Chasebarn35/ECEN404MatrixConverter/ECEN404FSM/db/ip/InternalClock/InternalClock__report.html

InternalClock

2024.11.07.12:48:01 | Datasheet

Overview

Memory Map

## int_osc_0

altera_int_osc v23.1

Parameters

INFORMATION | The output frequency for 10M02, 10M04, 10M08, 10M16, and 10M25 devices is 55~116MHz <br>The output frequency for 10M40, and 10M50 devices is 35~77MHz <br>
DEVICE_FAMILY | MAX10FPGA
PART_NAME | 10M04SAE144C8G
DEVICE_ID | 04
CLOCK_FREQUENCY_1 | 55
CLOCK_FREQUENCY_2 | 77
CLOCK_FREQUENCY | 55
CBX_AUTO_BLACKBOX | ALL
deviceFamily | UNKNOWN
generateLegacySim | false

Software Assignments
(none)

generation took 0.00 seconds | rendering took 0.01 seconds
