Chasebarn35/ECEN404MatrixConverter/Presentations/ECEN 403 Midterm Presentation.pptx

## 3-Phase Matrix Converter Chase Barnes Daniel Loeza Shanelle Algama


## Project Description

Problem statement:
Conventional 3 Phase Motor Drivers, Variable Frequency Drives (VFDs) use AC-DC-AC Conversion
This results in decreased efficiency, along with high Harmonic Distortion that can cause problems for the connected equipment

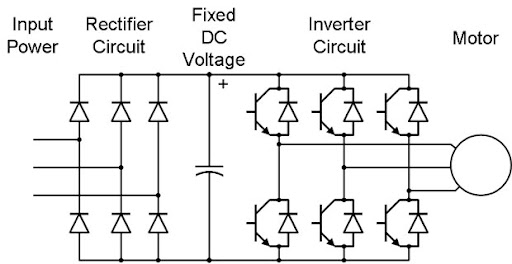
[picture p14: figure]

Notes: Chase

## Project Description

Our Matrix Converter will provide AC-AC power, and will have higher efficiency at lower frequencies than VFDs traditionally do, along with lower harmonic distortion.

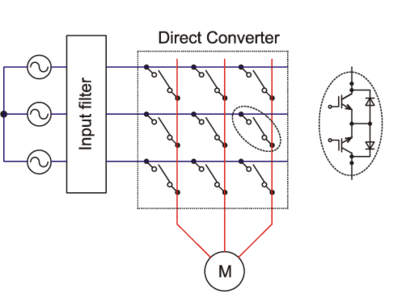
[picture p15: figure]

Notes: Chase

## Project Description

This converter will have three subsystems, which are the matrix of bidirectional switches with input filter and varistors on the input and output three-phase, the pulse generator circuit to control the switches, and the firmware, which will control the frequency of the output. The input will be 208V 60Hz three-phase power and the output will be 208V variable 0-60Hz three-phase power.

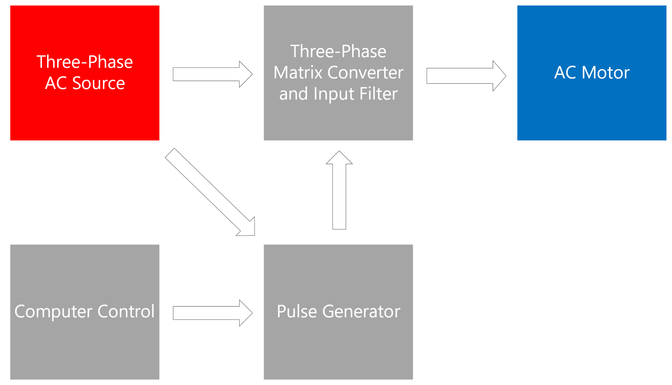
[picture p16: figure]

Notes: Shanelle

## System Overview


Notes: Shanelle

## Matrix Converter Circuit Board

This is the power electronics system designed to perform direct AC-AC conversion without an intermediate DC link.
- The source three-phase AC power will be directly connected to the input stage of the converter, which includes varistors for overvoltage protection and an input filter. (LC)
- Utilizes a 3x3 matrix of bidirectional semiconductor switches which comprises of two IGBT transistors and two gate drivers.
  - This will total to 18 IGBT transistors and 18 gate drivers
- Will include three more varistors on the output phases

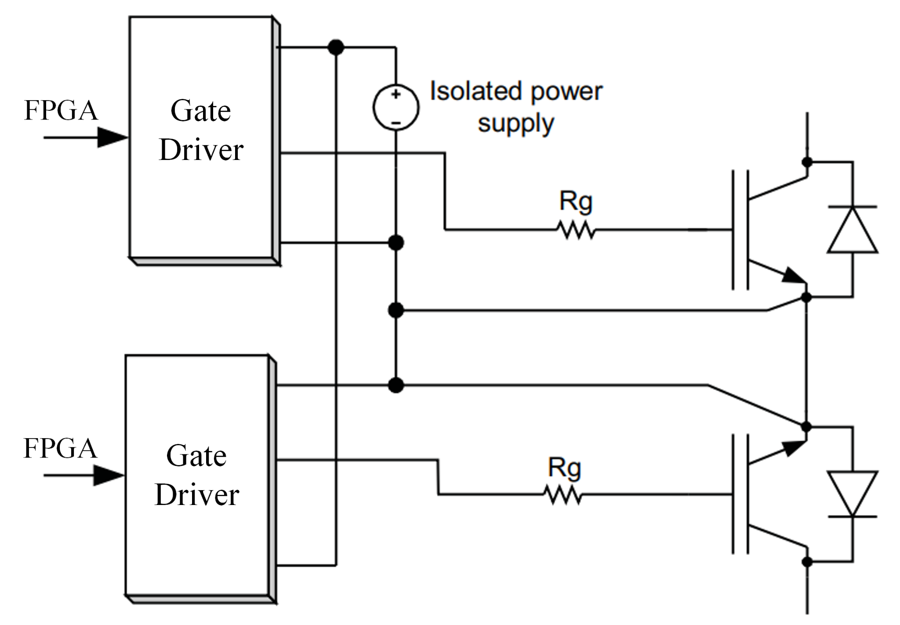
[picture p17: figure]

Bidirectional Switch with Common Emitter Configuration

Notes: Shanelle

## Pulse Generator Circuit Board

The Pulse Generator Circuit Board will house 3 sensors. These sensors will be Zero Crossing Sensors, Current Signal Detectors, and Short Circuit Detectors.
The Zero Crossing Sensor will detect when the all 3 phases change their signs.
The Current Signal Sensor will detect when either current is flowing into the load or out of the load.
The Short Circuit Sensor will detect for any short circuits within the Matrix Converter.
All outputs of these sensors will feed into the MCU/FPGA to trigger appropriate stages.

Notes: Daniel

## Microcontroller and FPGA Firmware

FPGA Firmware:
Safe Commutation System
Allows Bidirectional Switches to not short
Microcontroller Firmware:
Modeling the design virtually as a 2 stage rectifier and inverter stage allows for utilization of the Space Vector Modulation Algorithm. This is able to provide the correct load output for each phase to then be fed into the FPGA

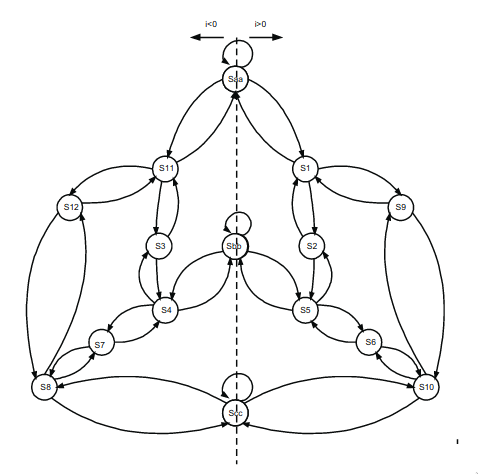
[picture p18: figure]
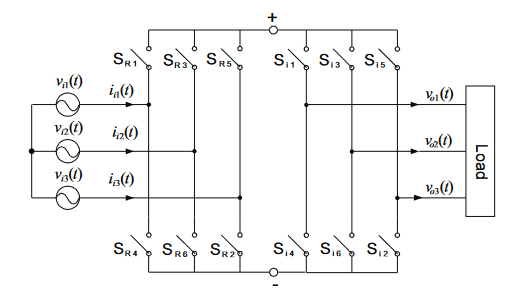
[picture p19: figure]

Notes: Chase

## Matrix Converter Circuit Board Progress

Part Type | Part Name | Info | Price | Cons
IGBT | STGW19NC60HD (https://www.digikey.com/en/products/detail/stmicroelectronics/STGW19NC60HD/2035565) | 600V 19A 97ns Td off | $3.11 Per $55.98 18x | Price
| STGP19NC60HD (https://www.digikey.com/en/products/detail/stmicroelectronics/STGP19NC60HD/2035589) | 600V 19A 97ns Td off | $2.72 Per $48.96 18x | Price
| IKP10N60TXKSA1 (https://www.digikey.com/en/products/detail/infineon-technologies/IKP10N60TXKSA1/2338008) | 600V 10A 215ns Td off 5 μs Short Protection | $1.73 Per $31.14 18x | Price Slow Td off
| STGF10M65DF2 (https://www.digikey.com/en/products/detail/stmicroelectronics/STGF10M65DF2/7313439) | 650V 10A 96ns Td off 6 μs Short Protection | $1.25 Per $22.50 18x | Plastic Packaging
Gate Drivers | HCPL-3150-000E (https://www.digikey.com/en/products/detail/broadcom-limited/HCPL-3150-000E/1236126) | 0.6 A max output 0.5 A min output | $3.26 per $58.68 18x | Price
| HCPL-315J-500E (https://www.digikey.com/en/products/detail/broadcom-limited/HCPL-315J-500E/1234709) | 0.6 A max output 0.5 A min output 2 Gate Drivers Less Components | $6.87 per $49.84 10x | Price
| HCPL-0302-000E (https://www.digikey.com/en/products/detail/broadcom-limited/HCPL-0302-000E/1236302) | 0.4 A max output 0.2 A min output | $2.24 per $26.93 18x | Lower Amperage Output
Varistor | B72220S0151K101 (https://www.digikey.com/en/products/detail/epcos-tdk-electronics/B72220S0151K101/593850) | 240V 8kA
| B72214Q0151K101 (https://www.digikey.com/en/products/detail/epcos-tdk-electronics/B72214Q0151K101/651174) | 240V 8kA

## Pulse Generator Circuit Board Process

Part Type | Part Name | Info | Price | Cons
Microcontroller | STM32G491CET6 (https://www.digikey.com/en/products/detail/stmicroelectronics/STM32G491CET6/13592600) | 512KB Flash 48-LQFP 170MHz | $8.51 per | Price
| STM32G491KEU6 (https://www.digikey.com/en/products/detail/stmicroelectronics/STM32G491KEU6/13592606) | 512KB Flash 32-UFQFPN 170MHz | $7.93 per | Smaller Package size
| STM32H733VGT6 (https://www.digikey.com/en/products/detail/stmicroelectronics/STM32H733VGT6/13171213) | 1M Flash 100-LQFP 550MHz | $12.61 per | Price
| STM32H745ZIT6 (https://www.digikey.com/en/products/detail/stmicroelectronics/STM32H745ZIT6/10244385) | 2M Flash 144-LQFP Dual Core 240MHz, 480MHz | $18.85 per | Price
MCU Dev Board | NUCLEO-G431RB (https://www.digikey.com/en/products/detail/stmicroelectronics/NUCLEO-G431RB/10231584) | STM32G4, more IO 48MHz Clock | $15.96 per | Limited Clock to original Component
| NUCLEO-G431KB (https://www.digikey.com/en/products/detail/stmicroelectronics/NUCLEO-G431KB/10231583) | STM32G4, less IO 24MHz Clock | $12.77 per | Limited IO and Clock
| NUCLEO-H7A3ZI-Q (https://www.digikey.com/en/products/detail/stmicroelectronics/NUCLEO-H7A3ZI-Q/11482046) | STM32H7 | $29 per | Limited Clock
CPLD | LC4032V-25TN44C (https://www.digikey.com/en/products/detail/lattice-semiconductor-corporation/LC4032V-25TN44C/2751454) | 2.5ns delay time 32 Macroblocks 60mA output current 44-TQFP | $7.25 per $21.75 3x | Expensive Dev Board limited macroblock size
| LC4256ZE-B-EVN (https://www.digikey.com/en/products/detail/lattice-semiconductor-corporation/LC4256ZE-B-EVN/2641947) | ispMACH 4000ZE | $142.8 per | Price
| LC4256V-B-EVN (https://www.digikey.com/en/products/detail/lattice-semiconductor-corporation/LC4256V-B-EVN/6595756) | ispMACH 4000V | $199 per | Price

## Pulse Generator Circuit Board Cont.

Part Type | Part Name | Info | Price | Cons
FPGA | LCMXO3D-9400HC-6SG72I (https://www.digikey.com/en/products/detail/lattice-semiconductor-corporation/LCMXO3D-9400HC-6SG72I/11498309) | Onboard Flash 442368 RAM Bits 10mA output current | $34.85 per | Less Expensive that CPLDs No Additional Flash Requirements
| LCMXO3D-9400HC-5SG72C (https://www.digikey.com/en/products/detail/lattice-semiconductor-corporation/LCMXO3D-9400HC-5SG72C/11498286) | Onboard Flash 442368 RAM Bits 10mA output current Worse Operating Temp | $28.70 per | Less Expensive that CPLDs No Additional Flash Requirements Cheaper than Other
FPGA Dev Board | LCMXO3D-9400HC-B-EVN (https://www.digikey.com/en/products/detail/lattice-semiconductor-corporation/LCMXO3D-9400HC-B-EVN/11498279) | MACHXO3D | $94.8 per | Less Expensive than CPLD Devs
Zero Crossing | BM1Z003FJ-E2 (https://www.digikey.com/en/products/detail/rohm-semiconductor/BM1Z003FJ-E2/13532604) | 0 μs delay | $2.39 Per $14.34 6x | Price
Hall Effect | ACS730KLCTR-20AB-T (https://www.digikey.com/en/products/detail/allegro-microsystems/ACS730KLCTR-20AB-T/5995139) | 4.7V to 0.1 Range 1MHz Output +-20A | $4.27 per $32.04 10x | Price

## FPGA And MCU Firmware Progress

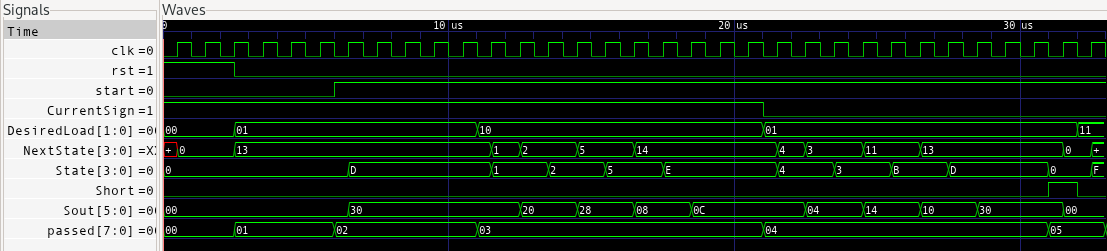
[picture p20: figure]
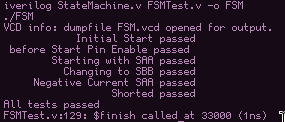
[picture p21: figure]

Notes: Chase

## Execution Plan

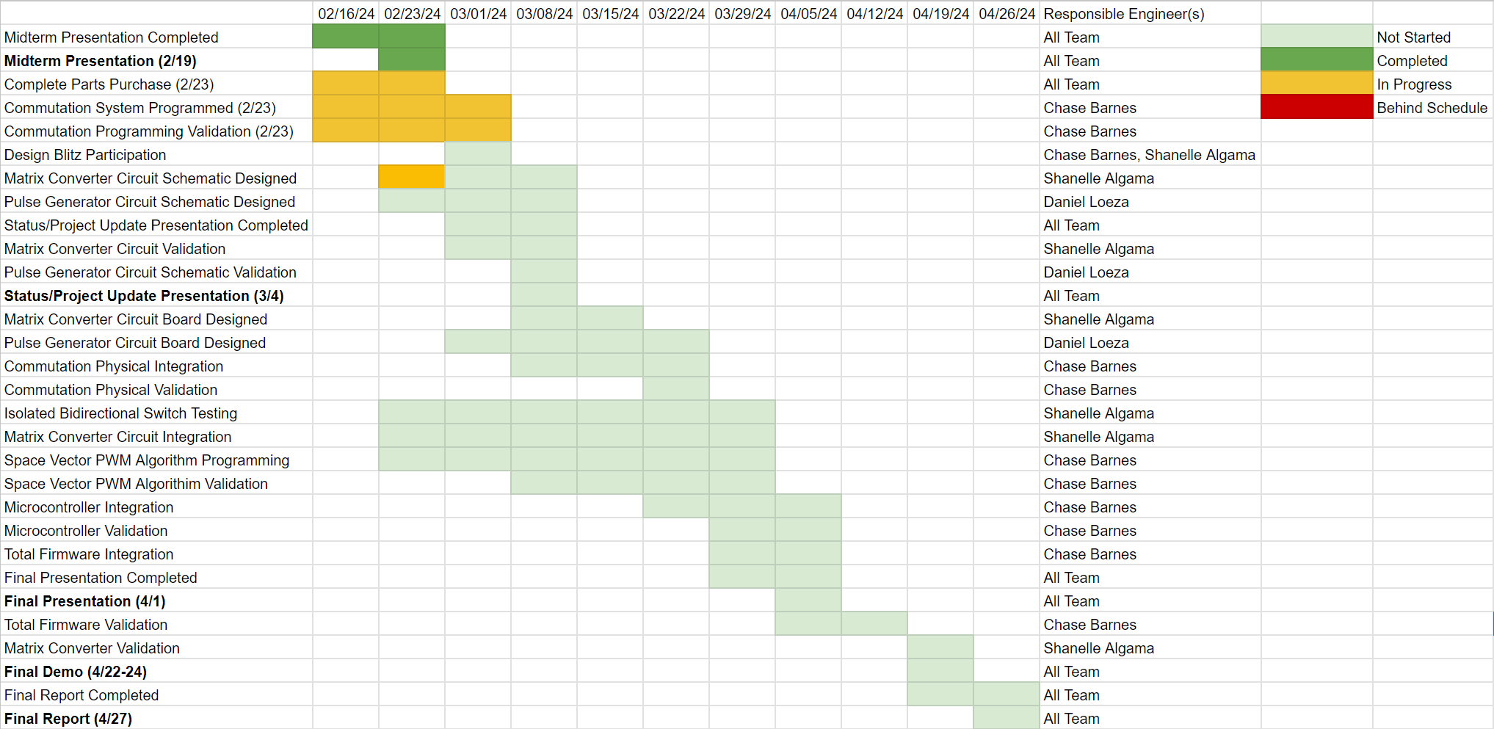
[picture p22: figure]

Notes: Daniel

## Validation Plan

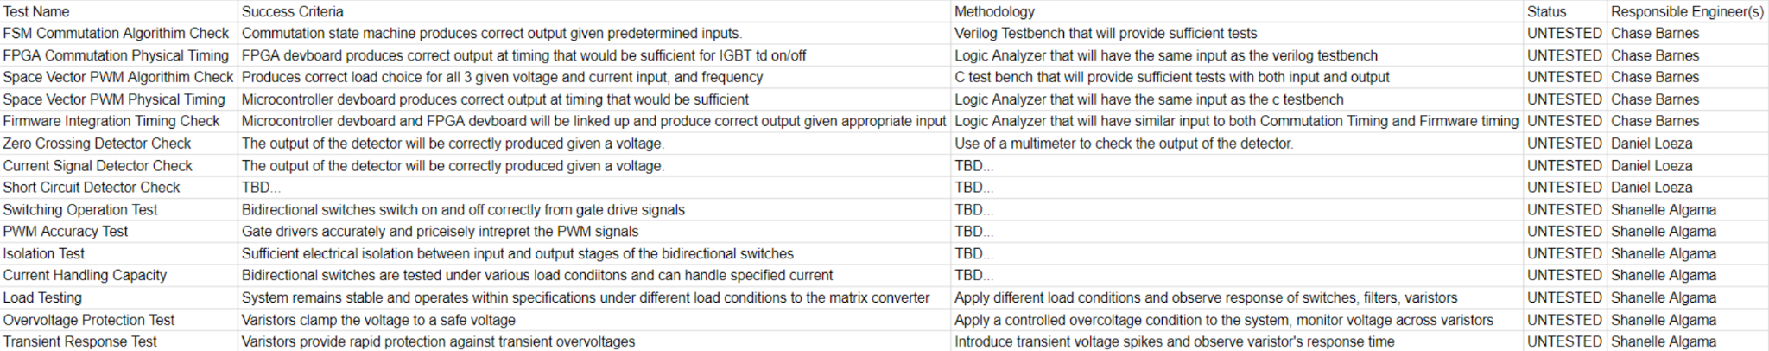
[picture p23: figure]

Notes: Daniel
