Chasebarn35/ECEN404MatrixConverter/PulseGenerator/PulseGenBoard.pdf

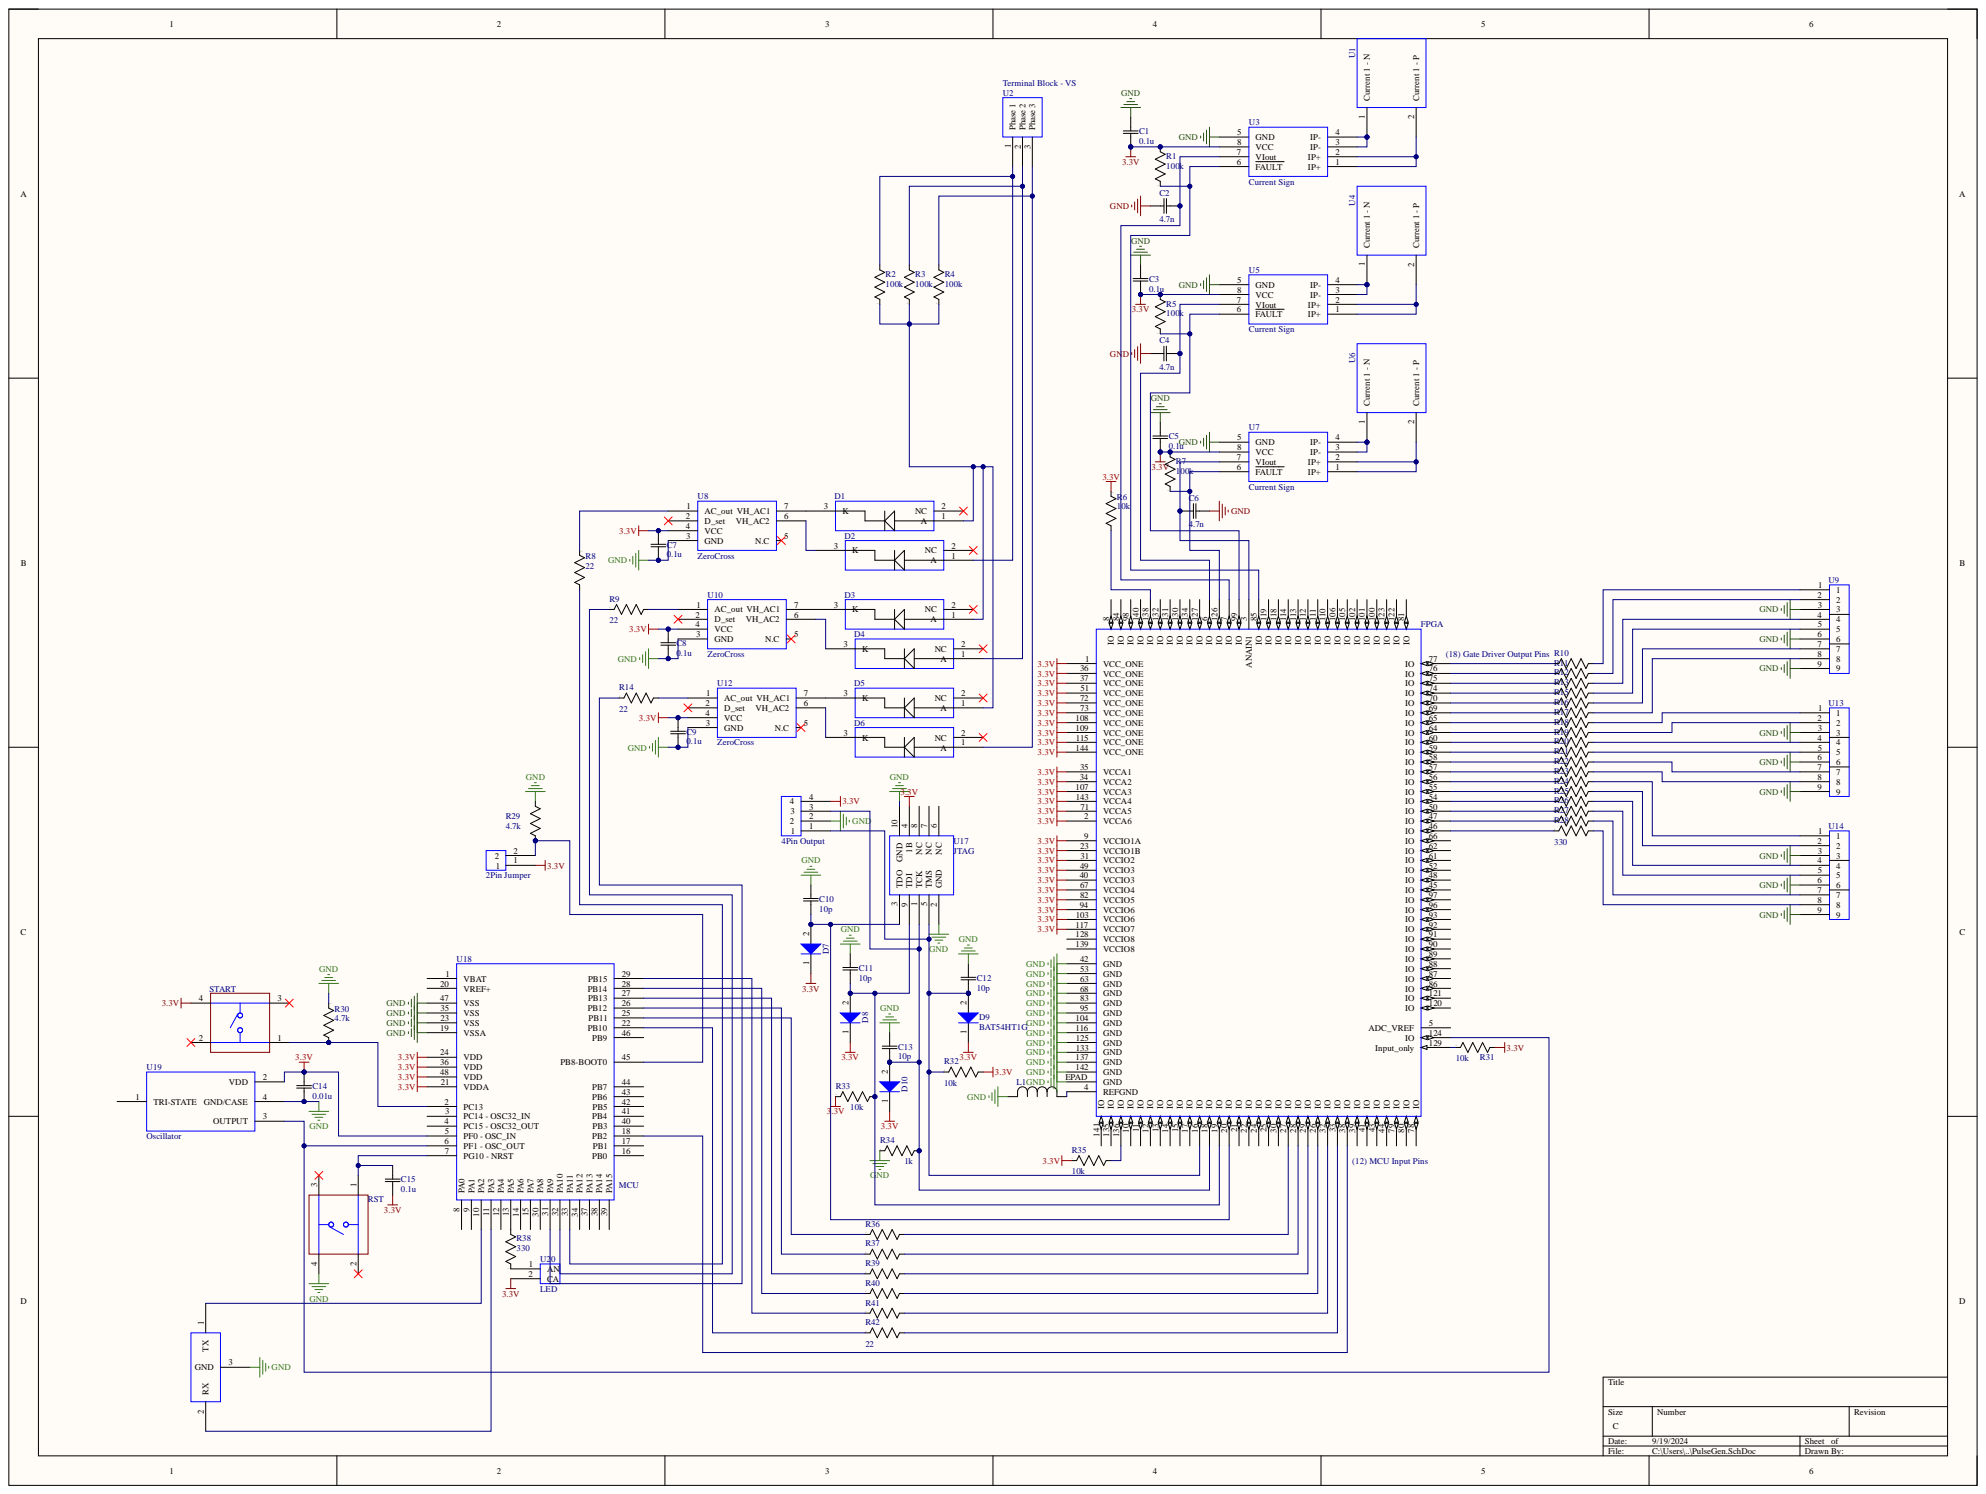
[picture p46: page 1]

Phase 3 3 Phase 2 2 Phase 1 1 U2 Terminal Block - VS

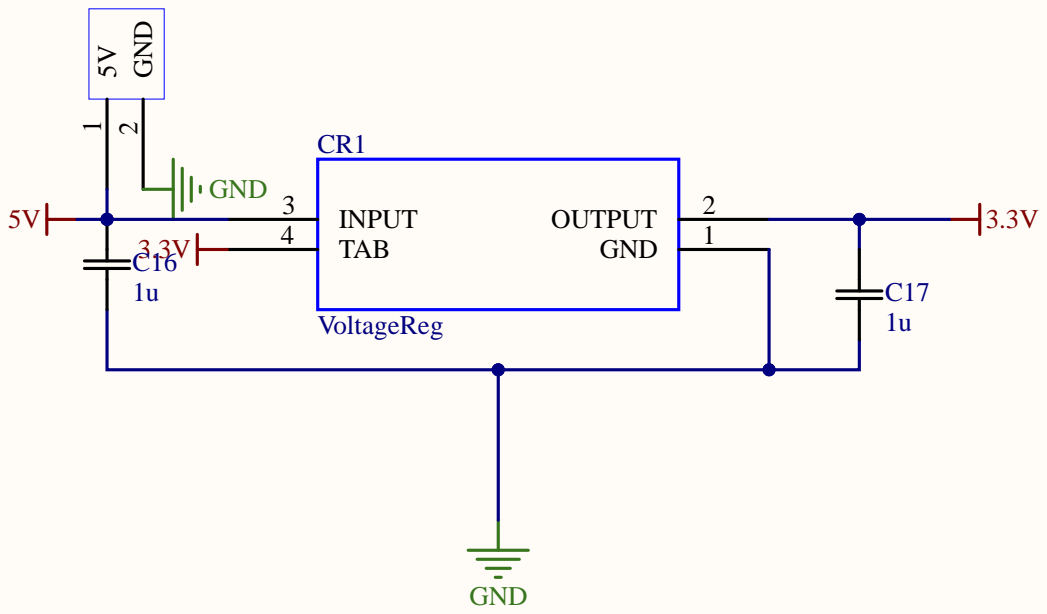
[picture p47: page 2]

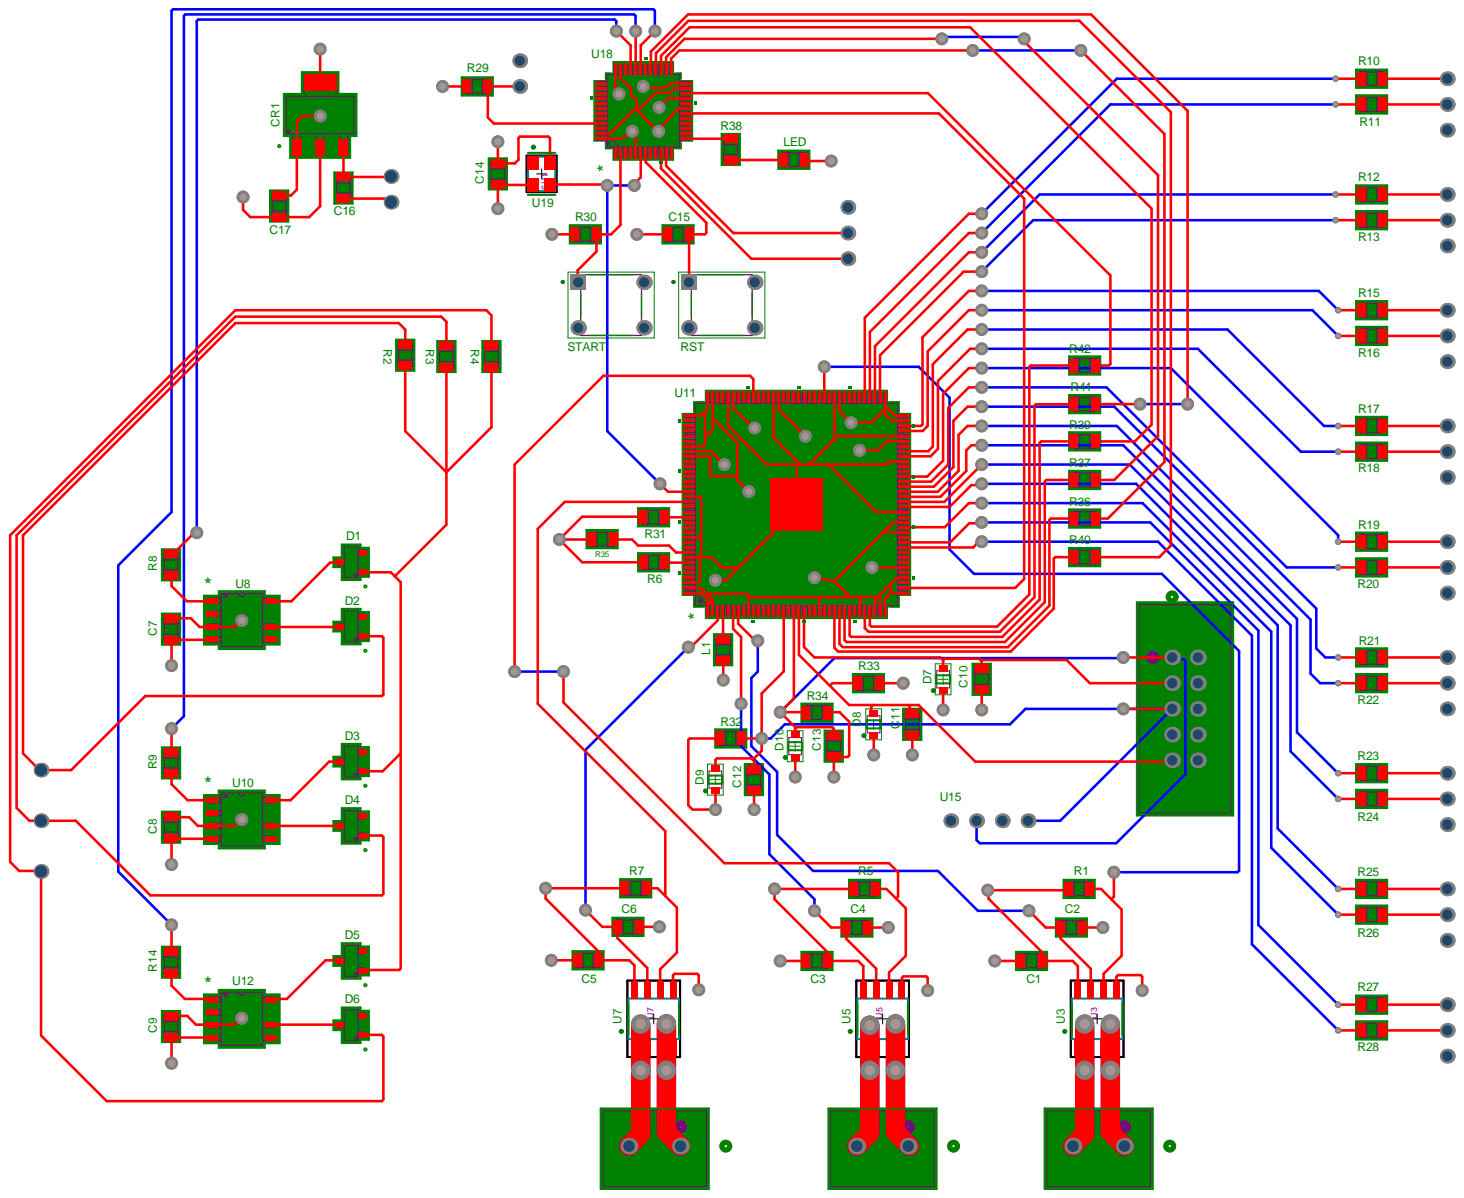
[picture p48: page 3]
