Chasebarn35/ECEN404MatrixConverter/(list of files, drawings)

Other design files:
BidirectionalSwitch.SchDoc
BidirectionalSwPCB.PcbDoc
InputFilter.PcbDoc
InputFilter.PrjPcb
InputFilter.SchDoc
OutputBoard.PcbDoc
OutputBoard.PrjPcb
OutputBoard.SchDoc
PulseGenerator/15to3.3V.SchDoc
PulseGenerator/PGBoard.PcbDoc
PulseGenerator/PulseGen.SchDoc
PulseGenerator/PulseGenBoard.PrjPcb
PulseGenerator/PulseGenFPLib.PcbLib
PulseGenerator/PulseGenSymLib.SchLib
PulseGenerator/RevisedPGBoard.PcbDoc
