Chasebarn35/ECEN404MatrixConverter/ECEN404FSM/db/ip/InternalClock/InternalClock.v

// InternalClock.v

// Generated using ACDS version 23.1 991

`timescale 1 ps / 1 ps
module InternalClock (
		output wire  clkout, // clkout.clk
		input  wire  oscena  // oscena.oscena
	);

	altera_int_osc #(
		.DEVICE_FAMILY   ("MAX 10"),
		.DEVICE_ID       ("04"),
		.CLOCK_FREQUENCY ("55")
	) int_osc_0 (
		.oscena (oscena), // oscena.oscena
		.clkout (clkout)  // clkout.clk
	);

endmodule
