Chasebarn35/ECEN404MatrixConverter/ECEN404FSM/ThresADC/synthesis/submodules/ThresADC_modular_adc_0_avalon_st_adapter_001_data_format_adapter_0.sv

// (C) 2001-2023 Intel Corporation. All rights reserved.
// Your use of Intel Corporation's design tools, logic functions and other 
// software and tools, and its AMPP partner logic functions, and any output 
// files from any of the foregoing (including device programming or simulation 
// files), and any associated documentation or information are expressly subject 
// to the terms and conditions of the Intel Program License Subscription 
// Agreement, Intel FPGA IP License Agreement, or other applicable 
// license agreement, including, without limitation, that your use is for the 
// sole purpose of programming logic devices manufactured by Intel and sold by 
// Intel or its authorized distributors.  Please refer to the applicable 
// agreement for further details.


// (C) 2001-2013 Altera Corporation. All rights reserved.
// Your use of Altera Corporation's design tools, logic functions and other 
// software and tools, and its AMPP partner logic functions, and any output 
// files any of the foregoing (including device programming or simulation 
// files), and any associated documentation or information are expressly subject 
// to the terms and conditions of the Altera Program License Subscription 
// Agreement, Altera MegaCore Function License Agreement, or other applicable 
// license agreement, including, without limitation, that your use is for the 
// sole purpose of programming logic devices manufactured by Altera and sold by 
// Altera or its authorized distributors.  Please refer to the applicable 
// agreement for further details.

 
// $Id: //acds/rel/13.1/ip/.../avalon-st_data_format_adapter.sv.terp#1 $
// $Revision: #1 $
// $Date: 2013/09/21 $
// $Author: dmunday $


// --------------------------------------------------------------------------------
//| Avalon Streaming Data Adapter
// --------------------------------------------------------------------------------

`timescale 1ns / 100ps

// ------------------------------------------
// Generation parameters:
//   output_name:        ThresADC_modular_adc_0_avalon_st_adapter_001_data_format_adapter_0
//   usePackets:         true
//   hasInEmpty:         true
//   inEmptyWidth:       1
//   hasOutEmpty:        false 
//   outEmptyWidth:      0
//   inDataWidth:        12
//   outDataWidth:       12
//   channelWidth:       5
//   inErrorWidth:       0
//   outErrorWidth:      0
//   inSymbolsPerBeat:   1
//   outSymbolsPerBeat:  1
//   maxState:           1
//   stateWidth:         1
//   maxChannel:         31
//   symbolWidth:        12
//   numMemSymbols:      1
//   symbolWidth:        12


// ------------------------------------------

 
module ThresADC_modular_adc_0_avalon_st_adapter_001_data_format_adapter_0 (
 // Interface: in
 output reg         in_ready,
 input              in_valid,
 input [12-1 : 0]    in_data,
 input [5-1 : 0] in_channel,
 input              in_startofpacket,
 input              in_endofpacket,
 input              in_empty,
 // Interface: out
 input                out_ready,
 output reg           out_valid,
 output reg [12-1: 0]  out_data,
 output reg [5-1: 0] out_channel,
 output reg           out_startofpacket,
 output reg           out_endofpacket,

  // Interface: clk
 input              clk,
 // Interface: reset
 input              reset_n

);


   always @* begin
      in_ready = out_ready; 
      out_valid = in_valid;
      out_data = in_data;
      out_channel = in_channel;
      out_startofpacket = in_startofpacket;
      out_endofpacket = in_endofpacket;
   end

endmodule

   
