Chasebarn35/ECEN404MatrixConverter/ECEN404FSM/ThresADC/ThresADC_inst.v

	ThresADC u0 (
		.clk_clk                         (<connected-to-clk_clk>),                         //                     clk.clk
		.modular_adc_0_threshold_valid   (<connected-to-modular_adc_0_threshold_valid>),   // modular_adc_0_threshold.valid
		.modular_adc_0_threshold_channel (<connected-to-modular_adc_0_threshold_channel>), //                        .channel
		.modular_adc_0_threshold_data    (<connected-to-modular_adc_0_threshold_data>),    //                        .data
		.reset_reset_n                   (<connected-to-reset_reset_n>)                    //                   reset.reset_n
	);
