Chasebarn35/ECEN404MatrixConverter/ECEN404FSM/unsaved/unsaved_inst.v

	unsaved u0 (
		.clk_clk           (<connected-to-clk_clk>),           //           clk.clk
		.pll_clk_50mhz_clk (<connected-to-pll_clk_50mhz_clk>), // pll_clk_50mhz.clk
		.reset_reset_n     (<connected-to-reset_reset_n>)      //         reset.reset_n
	);
