Chasebarn35/ECEN404MatrixConverter/ECEN404FSM/ThresADC/synthesis/submodules/altera_modular_adc_sample_store_ram.v

// (C) 2001-2023 Intel Corporation. All rights reserved.
// Your use of Intel Corporation's design tools, logic functions and other 
// software and tools, and its AMPP partner logic functions, and any output 
// files from any of the foregoing (including device programming or simulation 
// files), and any associated documentation or information are expressly subject 
// to the terms and conditions of the Intel Program License Subscription 
// Agreement, Intel FPGA IP License Agreement, or other applicable 
// license agreement, including, without limitation, that your use is for the 
// sole purpose of programming logic devices manufactured by Intel and sold by 
// Intel or its authorized distributors.  Please refer to the applicable 
// agreement for further details.


// megafunction wizard: %RAM: 2-PORT%
// GENERATION: STANDARD
// VERSION: WM1.0
// MODULE: altsyncram 

// ============================================================
// File Name: altera_modular_adc_sample_store_ram.v
// Megafunction Name(s):
// 			altsyncram
//
// Simulation Library Files(s):
// 			altera_mf
// ============================================================
// ************************************************************
// THIS IS A WIZARD-GENERATED FILE. DO NOT EDIT THIS FILE!
//
// 14.1.0 Internal Build 94 06/25/2014 PN Full Version
// ************************************************************


//Copyright (C) 1991-2014 Altera Corporation. All rights reserved.
//Your use of Altera Corporation's design tools, logic functions 
//and other software and tools, and its AMPP partner logic 
//functions, and any output files from any of the foregoing 
//(including device programming or simulation files), and any 
//associated documentation or information are expressly subject 
//to the terms and conditions of the Altera Program License 
//Subscription Agreement, the Altera Quartus II License Agreement,
//the Altera MegaCore Function License Agreement, or other 
//applicable license agreement, including, without limitation, 
//that your use is for the sole purpose of programming logic 
//devices manufactured by Altera and sold by Altera or its 
//authorized distributors.  Please refer to the applicable 
//agreement for further details.


// synopsys translate_off
`timescale 1 ps / 1 ps
// synopsys translate_on
module altera_modular_adc_sample_store_ram #(
    parameter DATA_WIDTH = 16
) (
	clock,
	data,
	rdaddress,
	rden,
	wraddress,
	wren,
	q);

	input	  clock;
	input	[DATA_WIDTH-1:0]  data;
	input	[5:0]  rdaddress;
	input	  rden;
	input	[5:0]  wraddress;
	input	  wren;
	output	[DATA_WIDTH-1:0]  q;
`ifndef ALTERA_RESERVED_QIS
// synopsys translate_off
`endif
	tri1	  clock;
	tri1	  rden;
	tri0	  wren;
`ifndef ALTERA_RESERVED_QIS
// synopsys translate_on
`endif

	wire [DATA_WIDTH-1:0] sub_wire0;
	wire [DATA_WIDTH-1:0] q = sub_wire0[DATA_WIDTH-1:0];

	altsyncram	altsyncram_component (
				.address_a (wraddress),
				.address_b (rdaddress),
				.clock0 (clock),
				.data_a (data),
				.rden_b (rden),
				.wren_a (wren),
				.q_b (sub_wire0),
				.aclr0 (1'b0),
				.aclr1 (1'b0),
				.addressstall_a (1'b0),
				.addressstall_b (1'b0),
				.byteena_a (1'b1),
				.byteena_b (1'b1),
				.clock1 (1'b1),
				.clocken0 (1'b1),
				.clocken1 (1'b1),
				.clocken2 (1'b1),
				.clocken3 (1'b1),
				.data_b ({DATA_WIDTH{1'b1}}),
				.eccstatus (),
				.q_a (),
				.rden_a (1'b1),
				.wren_b (1'b0));
	defparam
		altsyncram_component.address_aclr_b = "NONE",
		altsyncram_component.address_reg_b = "CLOCK0",
		altsyncram_component.clock_enable_input_a = "BYPASS",
		altsyncram_component.clock_enable_input_b = "BYPASS",
		altsyncram_component.clock_enable_output_b = "BYPASS",
		altsyncram_component.intended_device_family = "MAX 10",
		altsyncram_component.lpm_type = "altsyncram",
		altsyncram_component.numwords_a = 64,
		altsyncram_component.numwords_b = 64,
		altsyncram_component.operation_mode = "DUAL_PORT",
		altsyncram_component.outdata_aclr_b = "NONE",
		altsyncram_component.outdata_reg_b = "UNREGISTERED",
		altsyncram_component.power_up_uninitialized = "FALSE",
		altsyncram_component.ram_block_type = "M9K",
		altsyncram_component.rdcontrol_reg_b = "CLOCK0",
		altsyncram_component.read_during_write_mode_mixed_ports = "OLD_DATA",
		altsyncram_component.widthad_a = 6,
		altsyncram_component.widthad_b = 6,
		altsyncram_component.width_a = DATA_WIDTH,
		altsyncram_component.width_b = DATA_WIDTH,
		altsyncram_component.width_byteena_a = 1;


endmodule
