Chasebarn35/ECEN404MatrixConverter/(commit log)

2024-11-25 moved Daniel's work to PulseGenerator Folder
    [15to3.3V.SchDoc, PGBoard.PcbDoc, PulseGen.SchDoc, PulseGenBoard.PrjPcb, PulseGenFPLib.PcbLib, PulseGenSymLib.SchLib, RevisedPGBoard.PcbDoc]
2024-11-25 added ECEN404FSM which did not have available repository
    [ECEN404FSM.smp_dump.txt]
